cbm-instructions/never-dont-give-up/README.md

# Seat UP

Ein interaktiver Stuhl, dessen Sensoren dabei helfen die Sitzhaltung im Büroalltag nachhaltig zu verbessern.

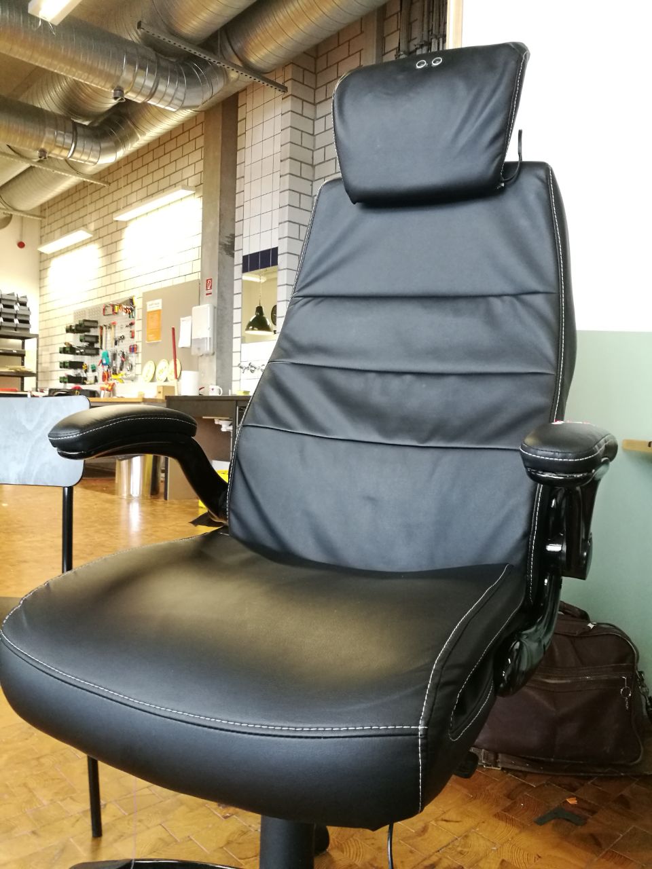
[picture p1: pictures/final2.jpeg]
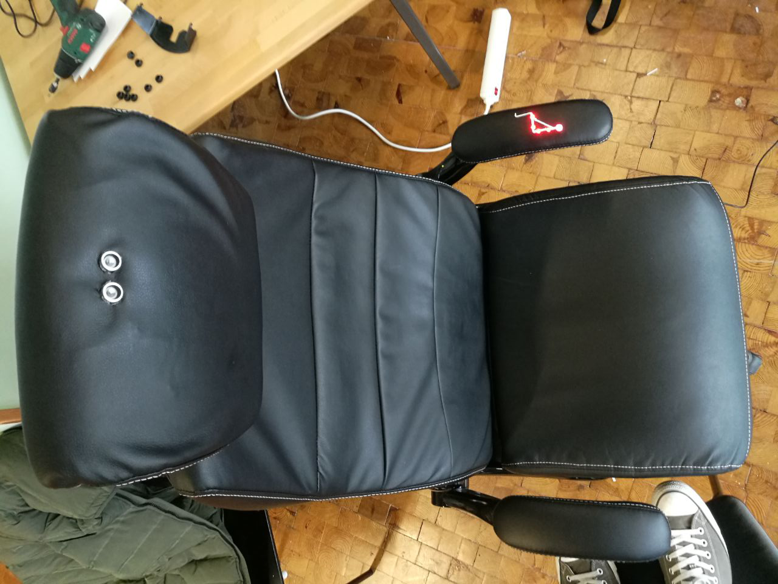
[picture p2: pictures/final.jpeg]
 

## Einleitung

Viele kennen es. Ständig klagt der Kollege aus dem Büro über Rückenschmerzen, der Tischnachbar über schmerzende Augen oder man selbst hat wieder einen steifen Hals.
Genau dieses Problem soll von nun an behaldelt werden, und das ganz ohne einen Arztbesuch.
Der Seat UP erinnert den Nutzer bei falscher Sitzhaltung via Vibration, sich wieder richtig hinzusetzen. Dabei messen Sensoren an kritischen Punkten den Kontakt zum Stuhl. 
Die verschiedenen Messpunkte werden dem Nutzer in der linken Armlehne angezeigt. Symbolisiert werden die Druckpunkte durch fünf LEDs, die jeweils in zwei verschiedenen Farben leuchten können. 

### Material und Werkzeug

Folgende Materialien werden für den Bau des Stuhls benötigt:

- Arduino Mega 2560 inkl USB-A auf B Kabel
- 7x Widerstandsresistoren
- 1x Transistor
- 1x Vibrationsmotor
- 5x Piranha RGB LEDs
- 1x Ultraschall Sensor
- 1x 2.9 inch Waveshare e-Paper module
- 1x Stuhl mit Arm- und Kopflehne
- 1x Korken
- Isolierband
- ca 15m Schaltlitze
- Isolierzange
- 15x 330 Ohm Widerstände
- 7x 10k Ohm Widerstände
- Karton
- Edding
- Schnur

Folgende Werkzeuge werden für den Bau des Stuhls benötigt:

- Heißklebepistole inkl Heißklebepatrone
- Schere
- Schlitz-Schraubenzieher
- Cuttermesser
- [Arduino IDE ](https://www.arduino.cc/en/main/software)
- [ePaper library](https://www.waveshare.com/wiki/2.9inch_e-Paper_Module_(B))
- [img2lcd](https://www.waveshare.com/wiki/2.9inch_e-Paper_Module_(B))
- ein beliebiges Endgerät mit einem Betriebssystem, welches mit der Arduino IDE kompatibel ist

## Vorbereitung

Um ein Programm für den Arduino zu schreiben bzw. um es darauf zu überspielen bietet sich die von Arduino selbst bereitgestellte IDE an. Zwar bietet diese nur eine sehr limitierte Funktionalität an, für unsere Zwecke ist das aber durchaus ausreichend. Die IDE kann [hier](https://www.arduino.cc/en/main/software) heruntergeladen werden.

## Step-by-step Guide

# 1. Stuhl demontieren
Zunächst wird der Stuhl benötigt.
Um sämtliche Sensoren unter dem Leder zu befestigen, muss dieser zuerst demotiert werden. Mit etwas Glück ist dieser getakert und nicht nur genäht. Somit müssen nur die Klammern entfernt werden.
Dies bewerkstelligt man am besten mit einem Schraubenzieher, um die Klammern anzuheben und mit einer Zange dann zu entfernen.

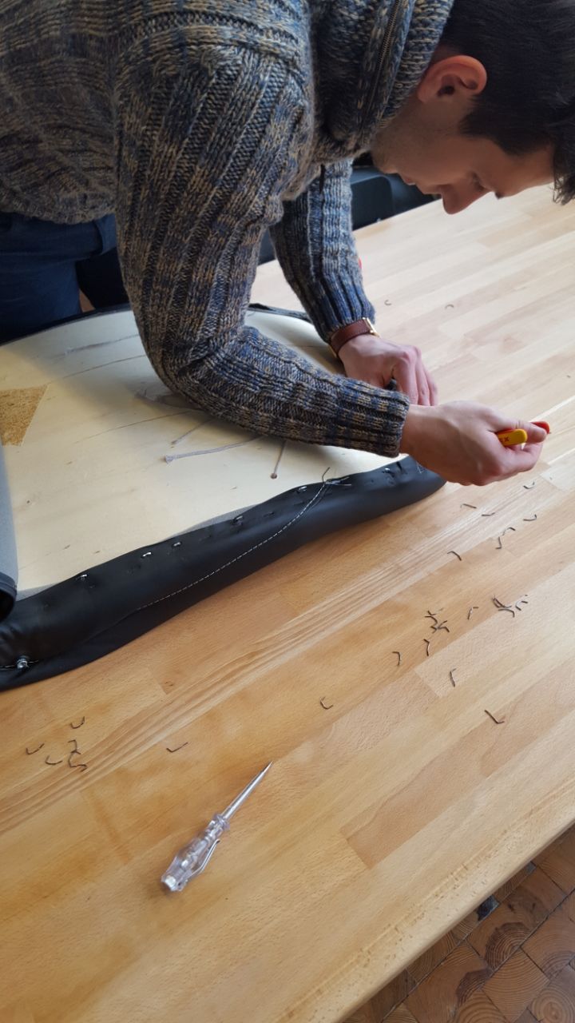
[picture p3: pictures/stuhl2.jpeg]


Ist dies geschafft, kann man die Vorderseite nun langsam herunter ziehen. Sollte man einen Stuhl mit Kopflehne haben, so muss man diese erst entfernen und zunächst die beiden Keile entnehmen.
Die Metallplatte, an der die Kopflehne befestigt ist haben wir ebenfalls entfernt, um mehr Spielraum zu haben.



# 2. Planung und Verlötung der Sensoren im Stuhl.
Als nächstes haben wir Überlegungen angestellt, wo wir die Drucksensoren positionieren, die Kabel verlaufen sollen und vor allem, wie wir das best mögliche Ergebnis bekommen.



Erst haben wir die Sensoren an der Oberfläche befestigt, um sie danach unter dem Leder zu montieren. Die Punkte haben wir voher mit einem Edding aufgemacht, sollte der Sensor verrutschen.
Bevor wir die Sensoren eingebaut haben, mussten wir jedoch noch zwei Schaltlitze anlöten. Eins für die Spannung, das andere zu einem 10k Ohm Widerstand welcher dann in den Ground geht.
Sicherheitshalber haben wir die Kabel noch mit Isolierband abgetrennt.

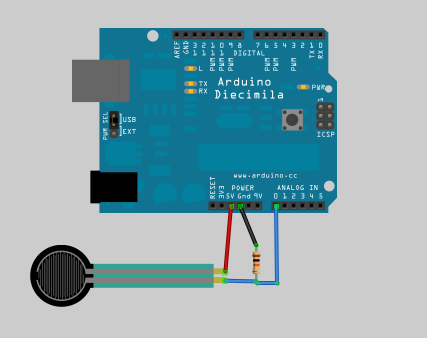
[picture p4: pictures/force___flex_fsrpulldowndia.png]


Nachdem wir mit einem Schraubbohrer in das Polster zwei Löcher mit ca. 5mm Durchmesser gebohrt haben, konnten wir den Sensor mit einer Schnur befestigen.

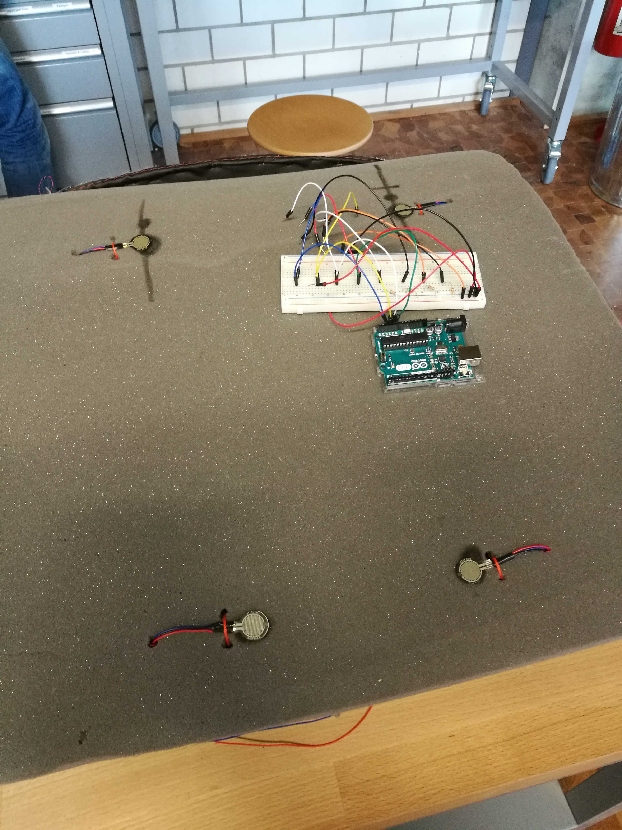
[picture p5: pictures/stuhl5.jpg]


Nach einem kurzen Testlauf mussten wir festestellen, dass die Sensoren durch den Schaumstoff nicht richtig betätigt wurden. Daher fertigten wir aus Kork und Pappe kleine Druckplatten, welche dazu dienen sollte die Druckfläche der einzelnen Sensoren zu vergrößern.

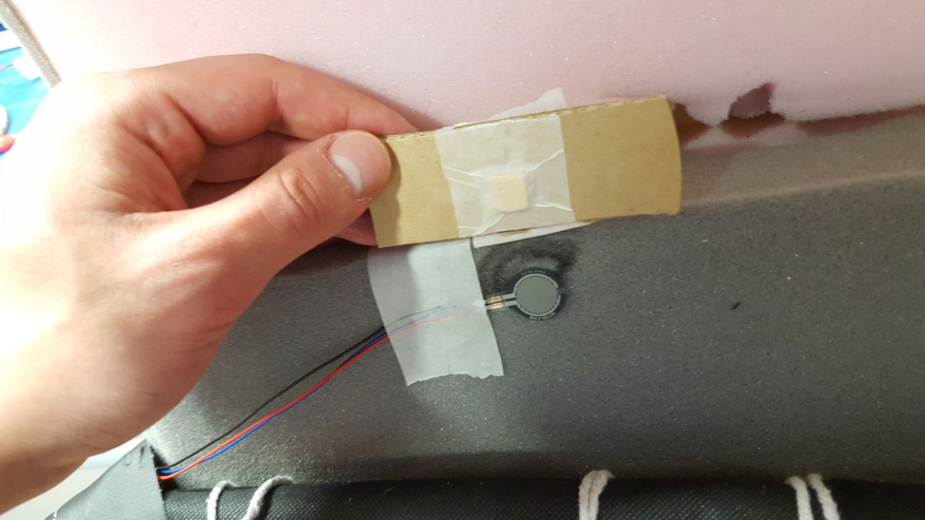
[picture p6: pictures/stuhl6.jpeg]


Für die Sitzfläche haben wir ingesamt 4 Drucksensoren verbaut. Zusammen mut zwei Sensoren für den oberen Rücken und einem für den unteren Rücken haben wir insgemsamt 7 Drucksensoren im Stuhl angebracht.

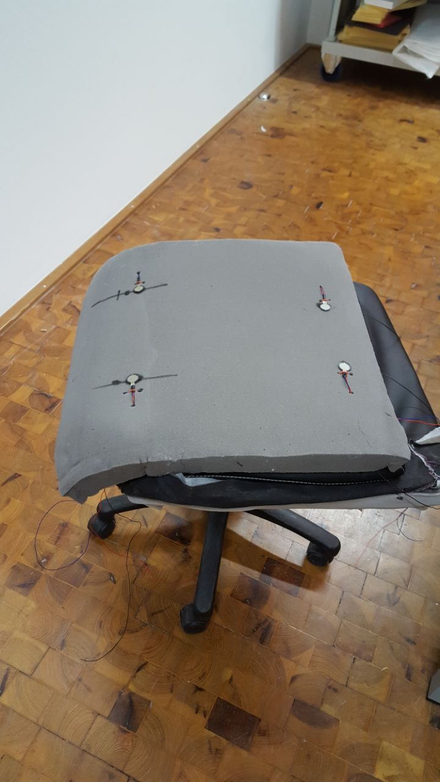
[picture p7: pictures/stuhl7.jpeg]


Den Stuhl lassen wir mithilfe eines kleinen Vibrationsmotors vibrieren. Diesen haben wir in Kork eingepackt um ihn vor dem Schaumstoff des Stuhls zu schützen und einen reibungsfreihen Ablauf zu gewährleisten. 

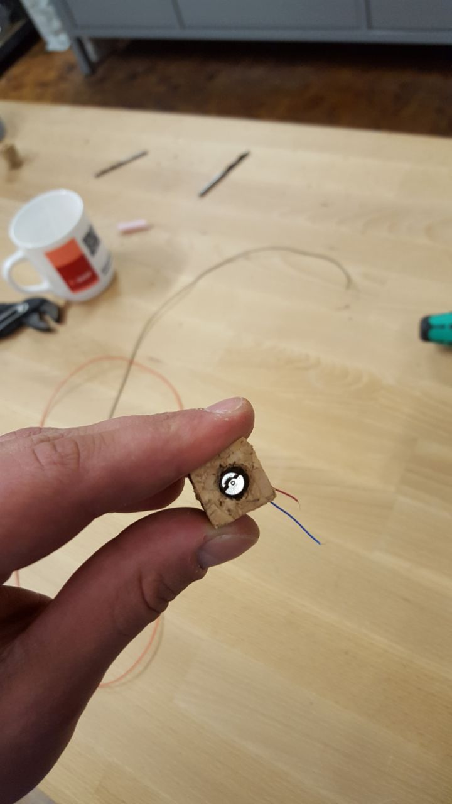
[picture p8: pictures/motor1.jpeg]


Im Anschluss wurde dieser mit einfachem Isoliertape verbunden und zwischen dem rechten Oberschenkel und Po verlegt.

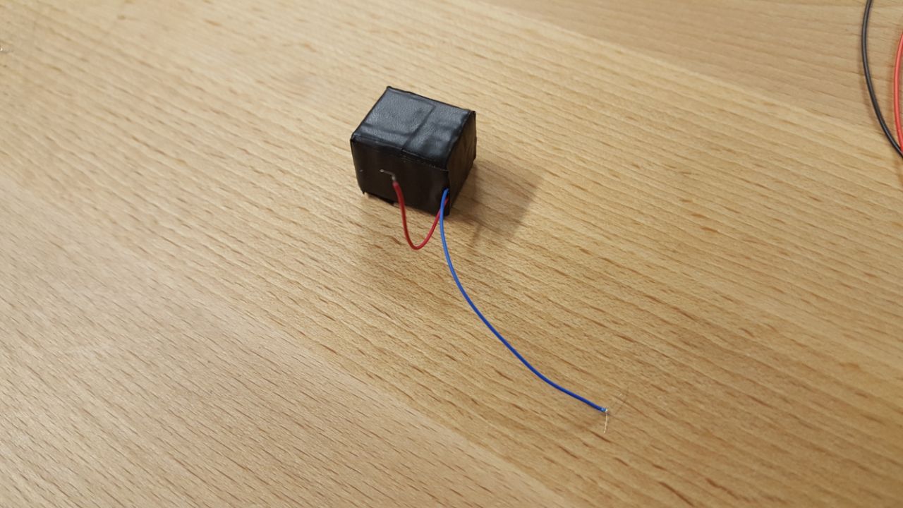
[picture p9: pictures/motor2.jpeg]


Unser Vibrationsmotor wird über zwei Kabel betrieben. Über das rote Kabel läuft eine Spannung (3,3V). Das schwarze Kabel mündet im Ground.
Um den Vibrationsmotor manuell steuern zu können, mussten wir zusätzlich noch einen Transistor verbauen (siehe Abb. unten).

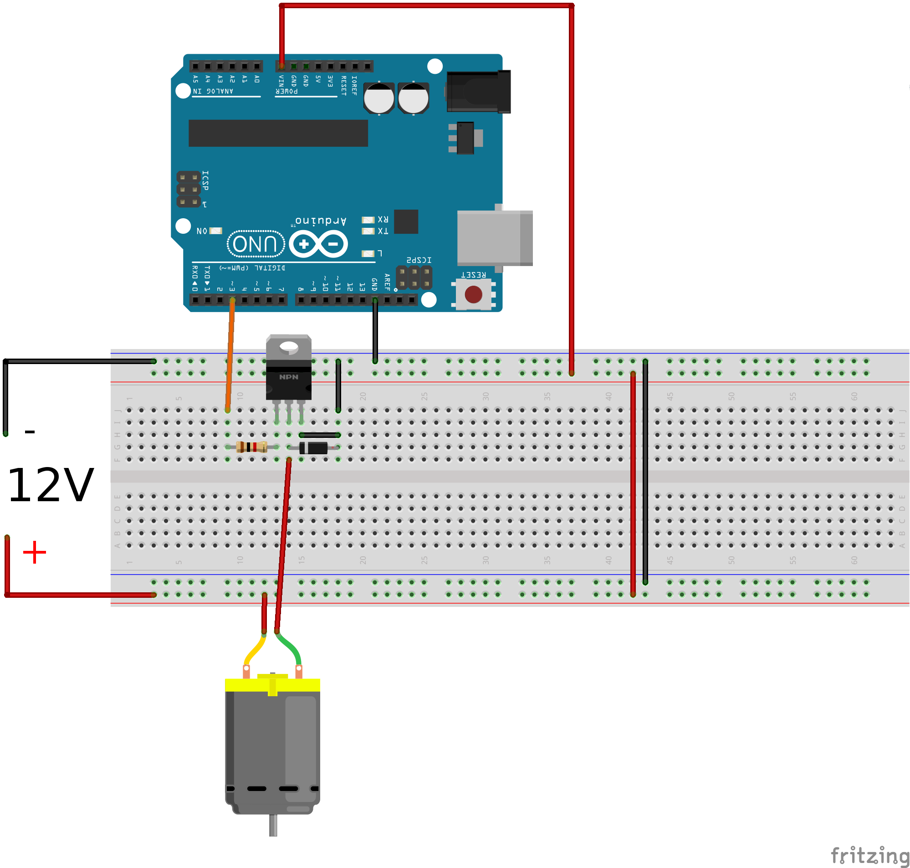
[picture p10: pictures/trans.png]


# 3. Ultraschall und Kopfpolster

Nachdem wir das Kopfpolster entfernt haben mussten wir uns überlegen, wie wir den Ultraschallsensor verbauen.
Zunächst haben wir das Polster etwas ausgedünnt, da es schlichtweg zu dick war um eine günstige Sitzhaltung zu gewähren.
Ursprünglich sollte der Ultraschall so platziert werden, um nur den Abstand zum Kopf zu messen. Nun liegt er so, dass sobald der Kopf zu weit nach vorne gebracht wird kein Signal entsteht.

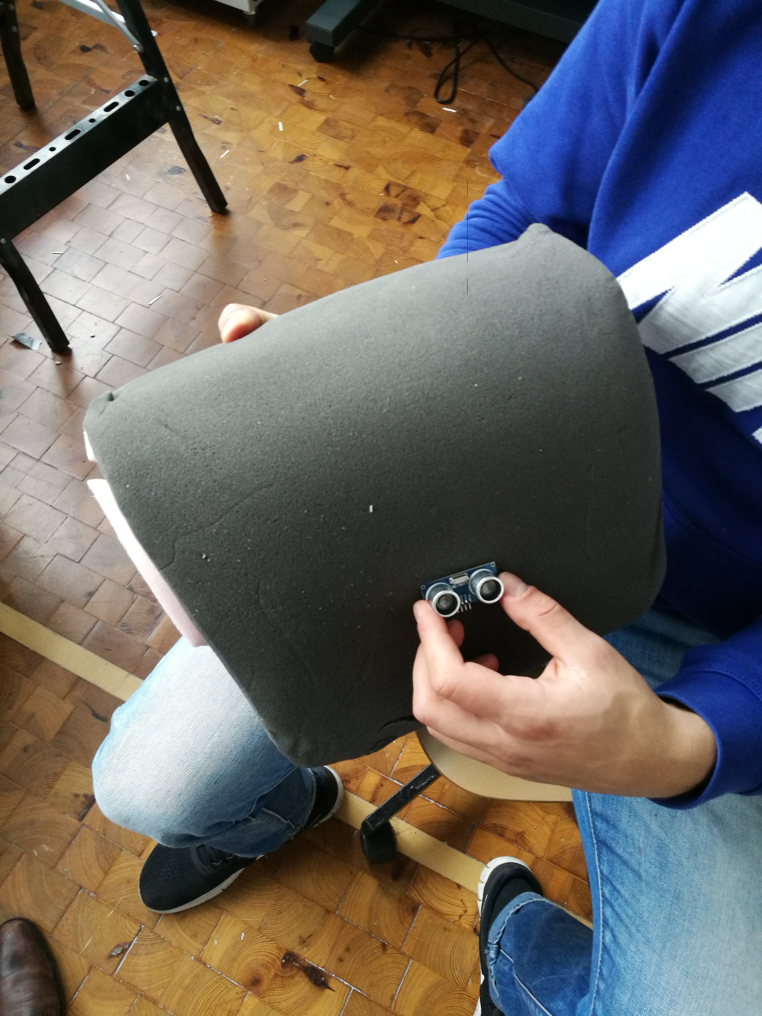
[picture p11: pictures/uss.jpg]


Verlötet wurde der Ultraschallsensor mit vier Schaltlitzen. Betrieben wird er mit einer 5V Spannung. Desweiteren benötigt man noch zwei Kabel für TRIGGER und ECHO. Der TRIGGER dient als Output-Signal aus dem Arduino und ECHO ist das Input-Signal welches den Messwert von Ultraschallsensor an den Arduino sendet. Das vierte Kabel mündet in den Ground.

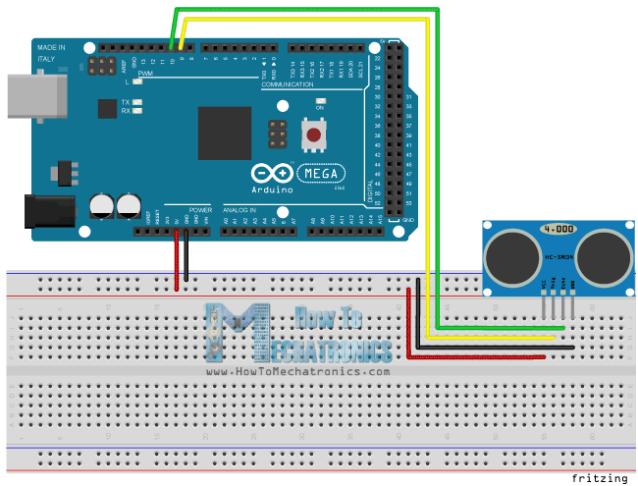
[picture p12: pictures/Ultrasonic-Sensor-Cirucit-Schematics-04.png]


Nachdem wir die richtige Position gefunden haben, haben wir zunächst einen rechteckigen Bereich markiert. Es wurden daraufhin zwei Löcher gebohrt, in den wir den Ultraschallsensor legen konnten. Danach wurde der Ultraschallsensor mit einer Schnur an das Brett der Kopflehne befestigt.

Rückseite             |  Vorderseite
:-------------------------:|:-------------------------:
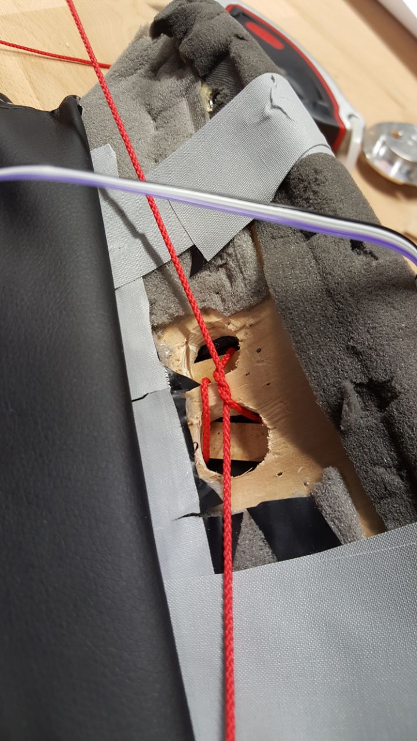
[picture p13: pictures/uss1.jpeg]
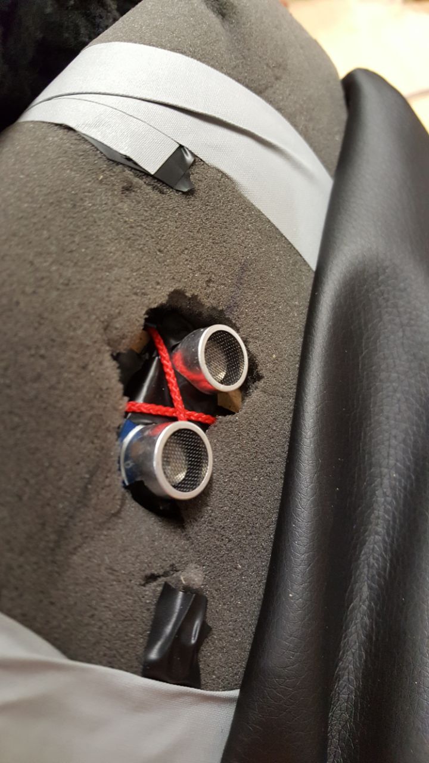
[picture p14: pictures/uss2.jpeg]
  |  

Als letzten Schritt mussten wir zwei Löcher in den Überzug der Kopflehne für den Sender und Empfänger machen. Diesen wurden mit Abtasten herausgefunden. Die Löcher wurden zunächst klein gemacht, und dann wenn nötig, vergrößert. Damit sich das Polster nicht über die beiden Zylinder zieht, haben wir diesen an den Ultraschallsensor geklebt. Nun ist der Ultraschallsensor verbaut und es sieht folgendermaßen aus:

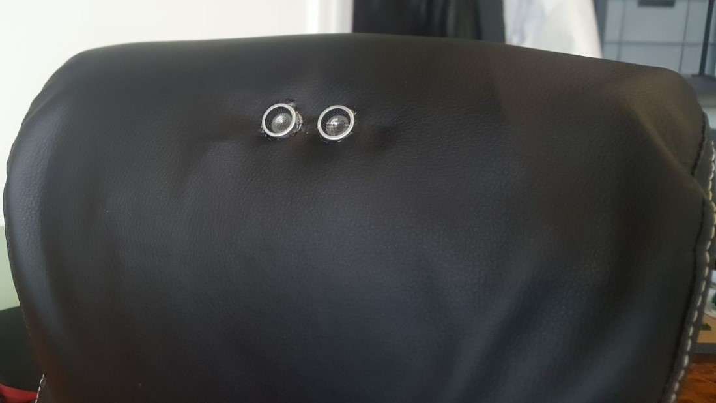
[picture p15: pictures/uss4.jpeg]
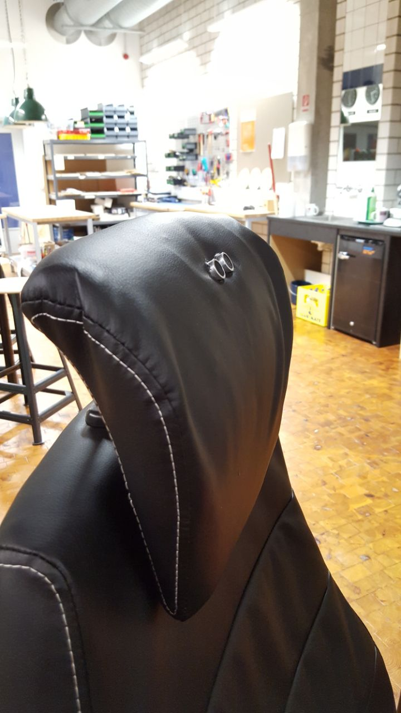
[picture p16: pictures/uss5.jpeg]
 

# 4. Armlehne und LED Anzeige

Zum Schluss folgt das Kernstück des Stühls, die Armlehne mit eingebauter LED Anzeige.
Zunächst wurde ein Schaltplan entworfen für die Piranha LEDs.
Dabei benötigt der Pin jeder Kante einen eigenen 330 Ohm Widerstand.

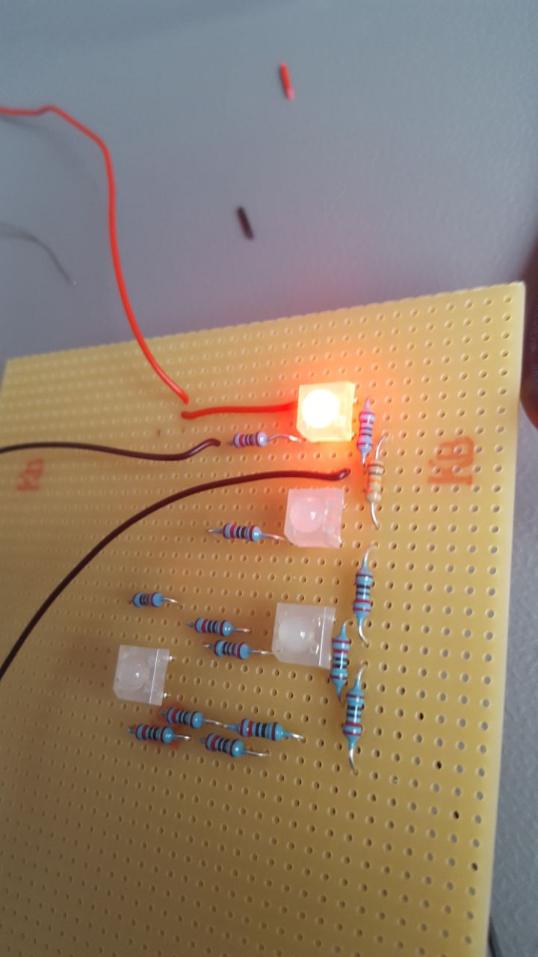
[picture p17: pictures/pir1.jpeg]


Piranha LEDs leuchten in drei Farben (R,G,B). Für jede der drei Farben gibt es einen Ausgang. Um eine Farbe oder eine Mischung aus verschiedenen Farben zu erhalten, müssen die jeweiligen Ausgänge der LEDs auf "LOW" geschaltet werden. Wir betreiben die Piranha LEDs mit 3,3V, da sie bei 5V zu hell leuchten würden.
Nachdem alles miteinander verlötet und angeschlossen wurde, haben wir einen kleinen Testlauf gemacht, um zu sehen, ob alles richtig funktioniert:

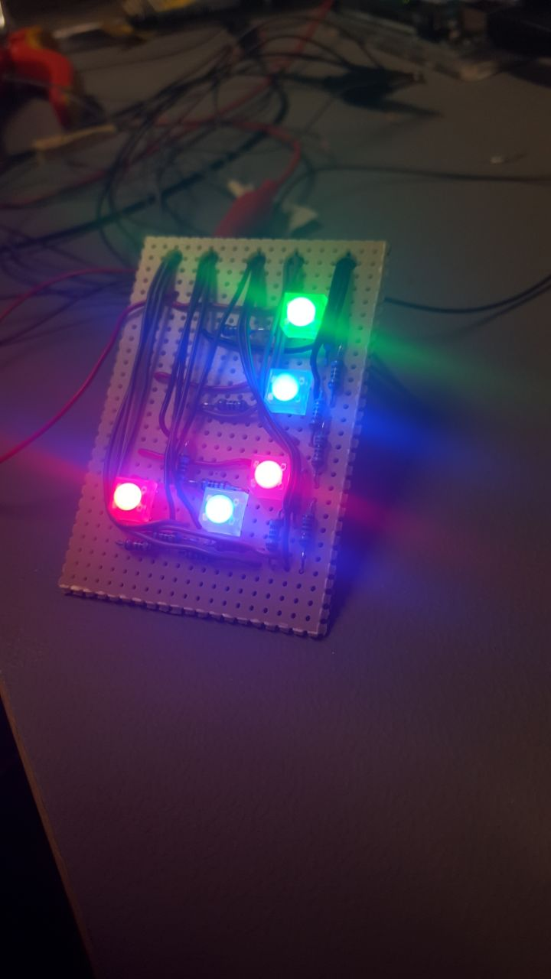
[picture p18: pictures/pir2.jpeg]


Der nächste Schritt war es die Platine mit den LEDs in der Armlehne zu verbauen. Wie vorhin schon erwähnt wurden hier die einzelnen Tacker entfernt und das Polster von der Armlehne getrennt. Nachdem die korrekte Position auf dem Schaumstoff gefunden wurde, haben wir sie zunächst markiert, indem wir unsere Platine mit den LEDs darauf gepresst haben.

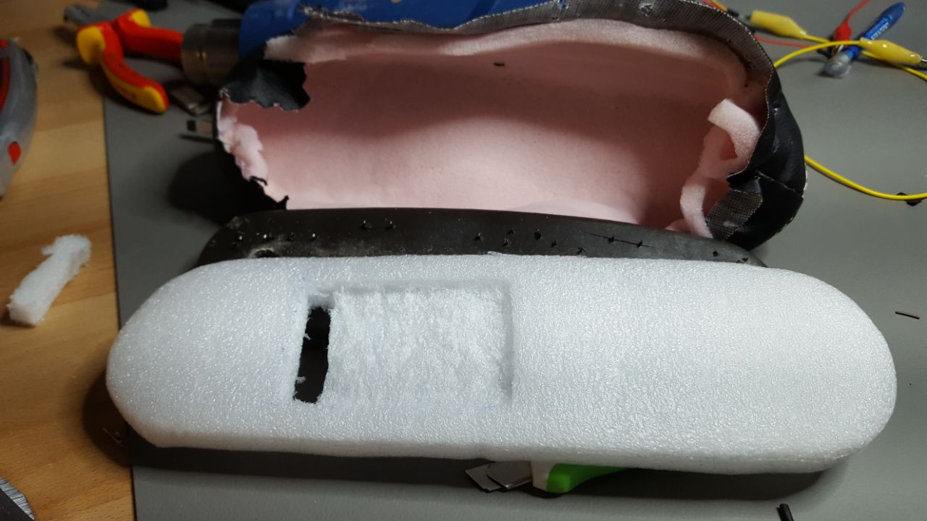
[picture p19: pictures/arm.jpg]


Ein kleiner Bereich davon wurde ausgeschnitten, damit wir die Kabel der Platine unter das Schaumstoff kriegen konnte. Die Platine wurde daraufhin mit Tape befestigt, sodass sie nicht abrutscht.

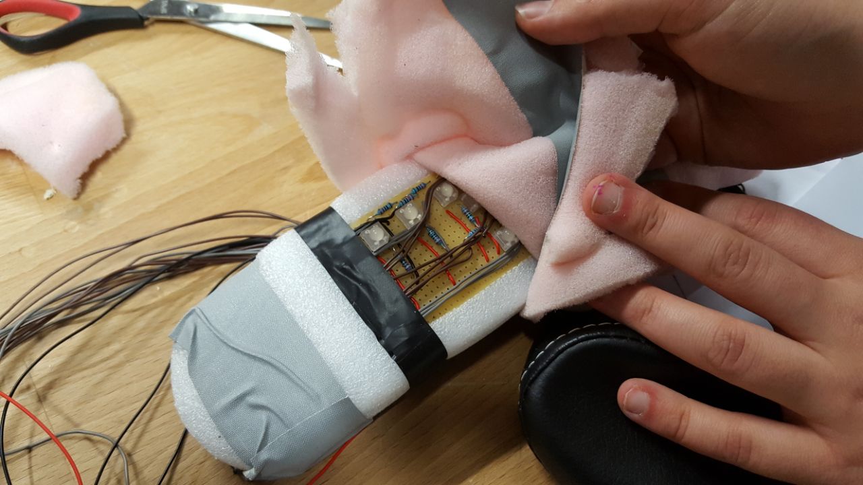
[picture p20: pictures/arm1.jpg]


Der pinke Überzug wurde dann mit Punkten markiert, welche die Position der LEDs markieren sollen. Diese Punkte wurden dann vorsichtig aufgeschnitten, sodass wir die LEDs durchstecken konnten.
Damit sich der Schaumstoff später nicht über die LEDs schiebt haben wir diesen mit Tape befestigt.

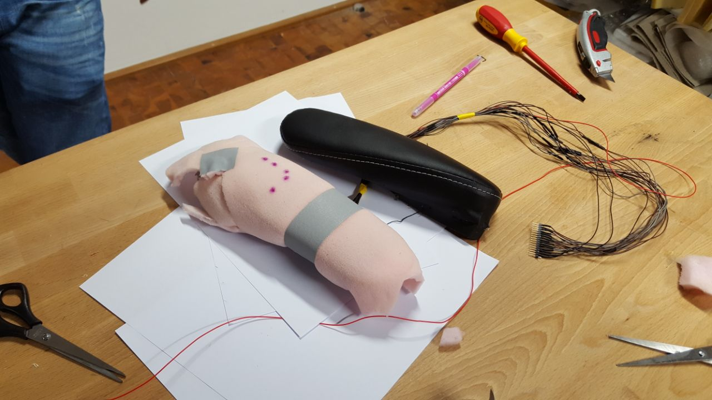
[picture p21: pictures/arm2.jpg]


Als letzten Schritt haben wir es wieder verpackt und die einzelne Bereiche, in denen sich die LEDs befinden wieder markiert. Diese Markierungen wurden nach dem gleichen Verfahren wie vorhin vorsichtig ausgeschnitten, sodass die LEDs durchleuchten können. Nachdem alles fertig war, haben wie Lehne wieder zugetackert.

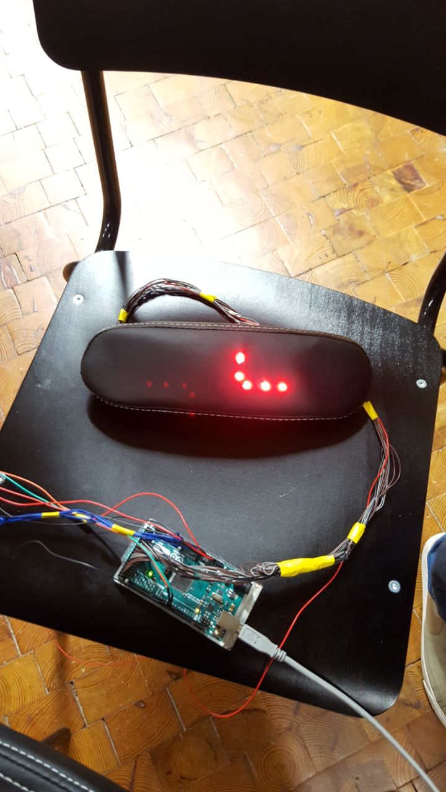
[picture p22: pictures/arm3.jpeg]


# 5. Code

[Hier](https://github.com/cbm-instructions/never-dont-give-up/tree/master/prototype-sketch) geht es zum Code.

# 6. Zukunftsaussichten

Ursprünglich sollte noch ein Waveshare E-Ink Display in dem Stuhl seinen Platz finden und eine wöchentliche Ansicht über die korrekte Sitzhaltung anzeigen.
Dafür wurde die verlinkte Bibliothek etwas umgeschrieben, weil das Display jeweils schwarze und rote Sketches malt.
Zusätzlich muss man ein Bild in einem Bildeditor der Wahl nach dem Maßen 128x296 Pixeln anfertigen, als .bmp abspeichern und im Programm IMG2LCD zu einem Array konvertieren, welches vom Arduino eingelesen wird. Dies muss in den PROGMEM gespeichert werden.

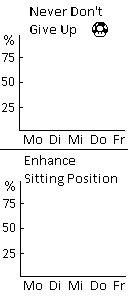
[picture p23: pictures/dia.bmp]
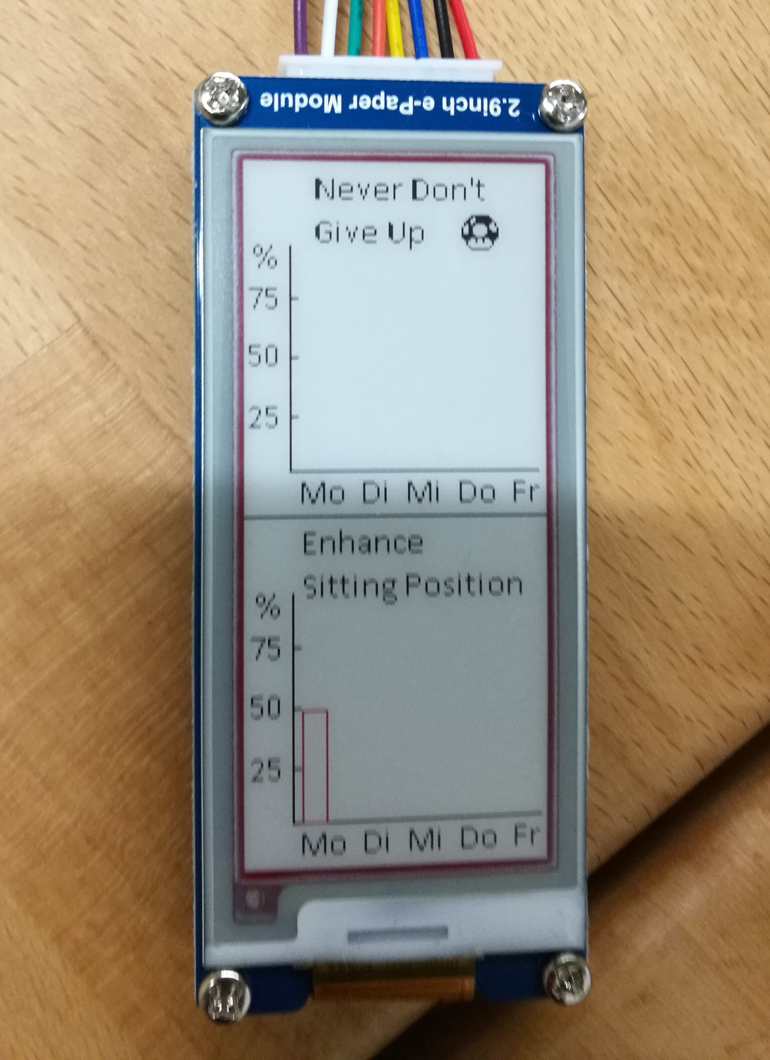
[picture p24: pictures/eink.jpg]
 | 

## Authors

* **Hamid Ahmetovic**
* **Mustafa Yildiz**
* **Josip Grabant**
