cbm-instructions/never-dont-give-up/pictures/IMG_20171214_134628.jpg

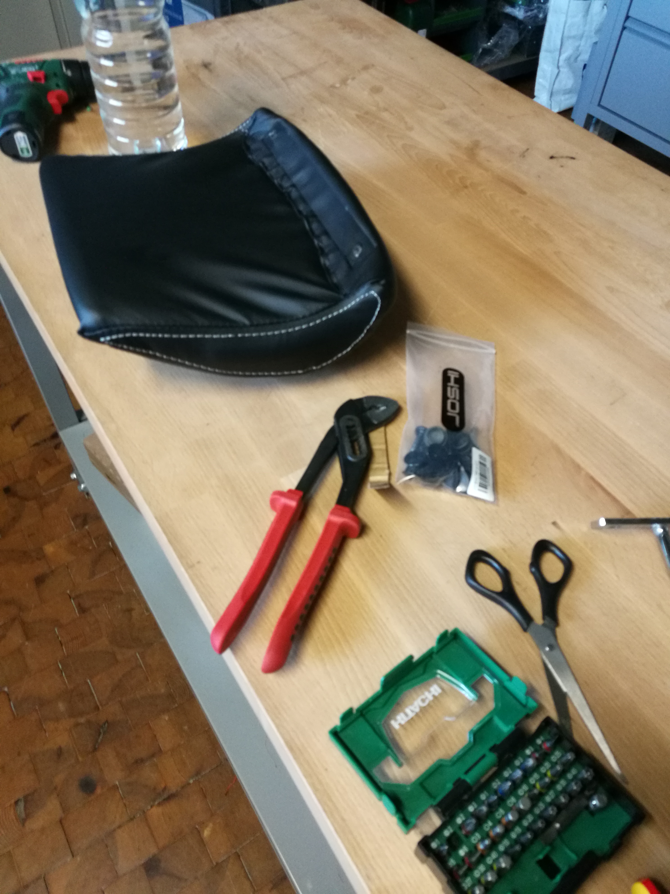
pictures/IMG_20171214_134628.jpg
