cbm-instructions/never-dont-give-up/pictures/stuhl1.jpg

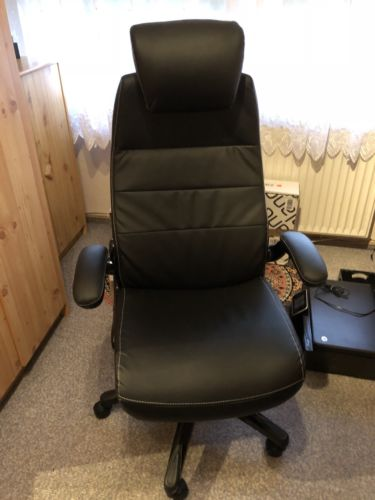
pictures/stuhl1.jpg
