cbm-instructions/never-dont-give-up/pictures/StuhlFertig.jpeg

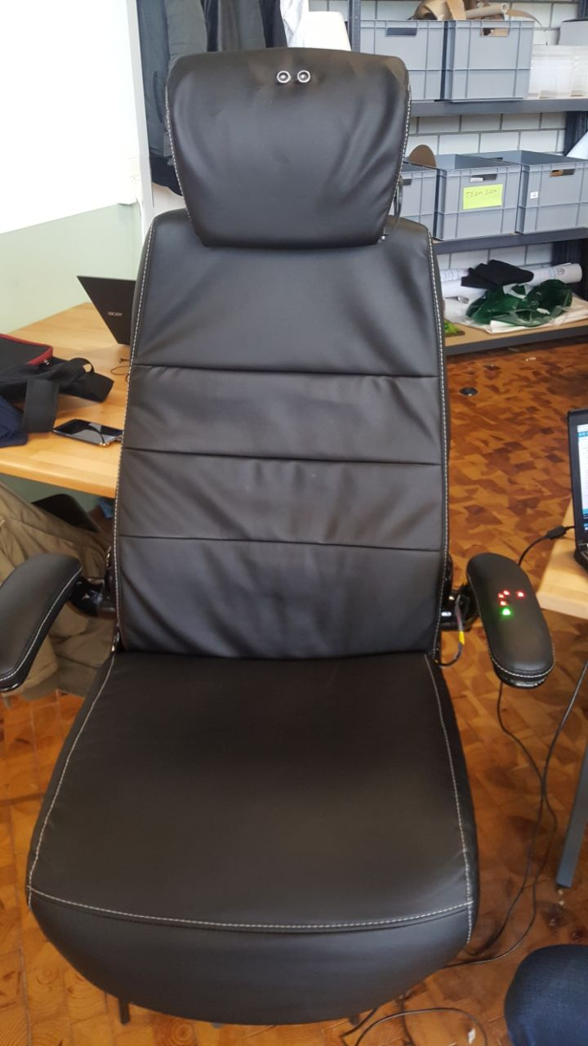
pictures/StuhlFertig.jpeg
