cbm-instructions/never-dont-give-up/pictures/uss3.jpeg

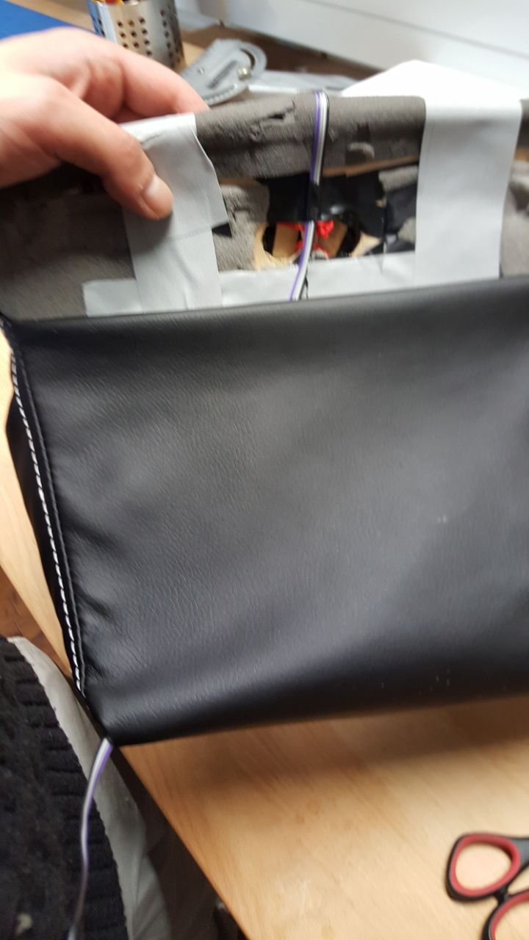
pictures/uss3.jpeg
